josue-dubois/Human_Tracker/production/bom.csv

Designator | Footprint | Quantity | Value | LCSC Part #
C1 | C1712_C0805 | 1 | 10uF | C1712
C10, C4 | C1712_C0805 | 2 | 0.1u | C1712
C11 | C1712_C0805 | 1 | 1nF (102) ±5% 50V | C1712
C12, C13 | C1712_C0805 | 2 | 4.7uF | C1712
C14 | C1712_C0805 | 1 | 1uF | C1712
C15, C16, C18 | C1712_C0805 | 3 | 100n | C1712
C17 | C15850_C0805 | 1 | 10uF | C15850
C2, C9 | C1712_C0805 | 2 | 100nF | C1712
C3 | C1712_C0805 | 1 | 10nF | C1712
C5 | C1712_C0805 | 1 | 47pF | C1712
C6 | C1712_C0805 | 1 | 4.7nF | C1712
C7 | C1712_C0805 | 1 | GRM21BR61A476ME15L 47uF | C1712
C8 | C1712_C0805 | 1 | 22uF | C1712
D1 | C7519_SOT-23-6_L2_9-W1_6-P0_95-LS2_8-BL | 1 | USBLC6-2SC6 | C7519
H2, H3 | C725946_HDR-TH_14P-P2_54-V-M | 2 | X6511WV-14H-C30D60 | C725946
H4 | C725944_HDR-TH_12P-P2_54-V-M | 1 | X6511WV-12H-C30D60 | C725944
H5 | C706875_HDR-TH_3P-P2_54-V-M | 1 | X6511WV-03H-C30D60 | C706875
L1 | C168078_IND-SMD_L6_0-W6_0_FNR60XXS | 1 | FNR6045S150MT 15uH | C168078
LED1 | C74338_LED0402-R-RD | 1 | 0402 | C74338
R1 | C17414_R0805 | 1 | 150kΩ | C17414
R11 | C17414_R0805 | 1 | 10k | C17414
R12, R8 | C17414_R0805 | 2 | 100k | C17414
R13, R14 | C17414_R0805 | 2 | 4.7k | C17414
R15, R16 | C17414_R0805 | 2 | 1k | C17414
R2 | C17414_R0805 | 1 | 62kΩ | C17414
R3, R5 | C17414_R0805 | 2 | 5.1k | C17414
R4 | C17414_R0805 | 1 | FRC0805F2102TS 21k | C17414
R6 | C17414_R0805 | 1 | 10kΩ | C17414
R7 | C17414_R0805 | 1 | 2.8KΩ (2801) ±1% | C17414
SM1 | C19723500_SENSOR-TH_HLK-LD2410C-P | 1 | HLK-LD2410C-P | C19723500
TP1 | TestPoint_Pad_D2.0mm | 1 | Buck In
TP2 | TestPoint_Pad_D2.0mm | 1 | Buck Out
TP3 | TestPoint_Pad_D2.0mm | 1 | LDO
TP4 | TestPoint_Pad_D2.0mm | 1 | UWB_TX
TP5 | TestPoint_Pad_D2.0mm | 1 | UWB_RX
TP6 | TestPoint_Pad_D2.0mm | 1 | UWB_RXOK
TP7 | TestPoint_Pad_D2.0mm | 1 | UWB_CS
U1 | C2865142_SOIC-8_L4_9-W3_9-P1_27-LS6_0-BL | 1 | TPS54233QDRQ1 | C2865142
U2, U3 | C5656610_MIC-SMD_6P-L3_5-W2_7-P0_90-BL | 2 | ICS-43434_C5656610 | C5656610
U4 | C514342_DFN-8_L3_0-W3_0-P0_50-BL-EP | 1 | ADM7172ACPZ-3.3-R7 | C514342
U5 | Bosch_LGA-8_3x3mm_P0.8mm_ClockwisePinNumbering | 1 | BME680
U6 | C2913202_WIRELM-SMD_ESP32-S3-WROOM-1 | 1 | ESP32-S3-WROOM-1(N16R8) | C2913202
U7 | C488251_TO-39-4_MLX90640ESF-BAB-000-TU | 1 | MLX90640ESF-BAB-000-TU | C488251
U8 | C2930166_R0805 | 1 | FRC0805F1400TS 140 | C2930166
USB1 | C7095263_USC-C-SMD_USB4085-GF-A | 1 | USB4085-GF-A_C7095263 | C7095263
WIRELM1 | C3028890_WIRELM-SMD_DWM3000 | 1 | DWM3000 | C3028890
