josue-dubois/Human_Tracker/Human_Tracker.kicad_pcb

## KiCad design Human_Tracker.kicad_pcb (2026-10-14)

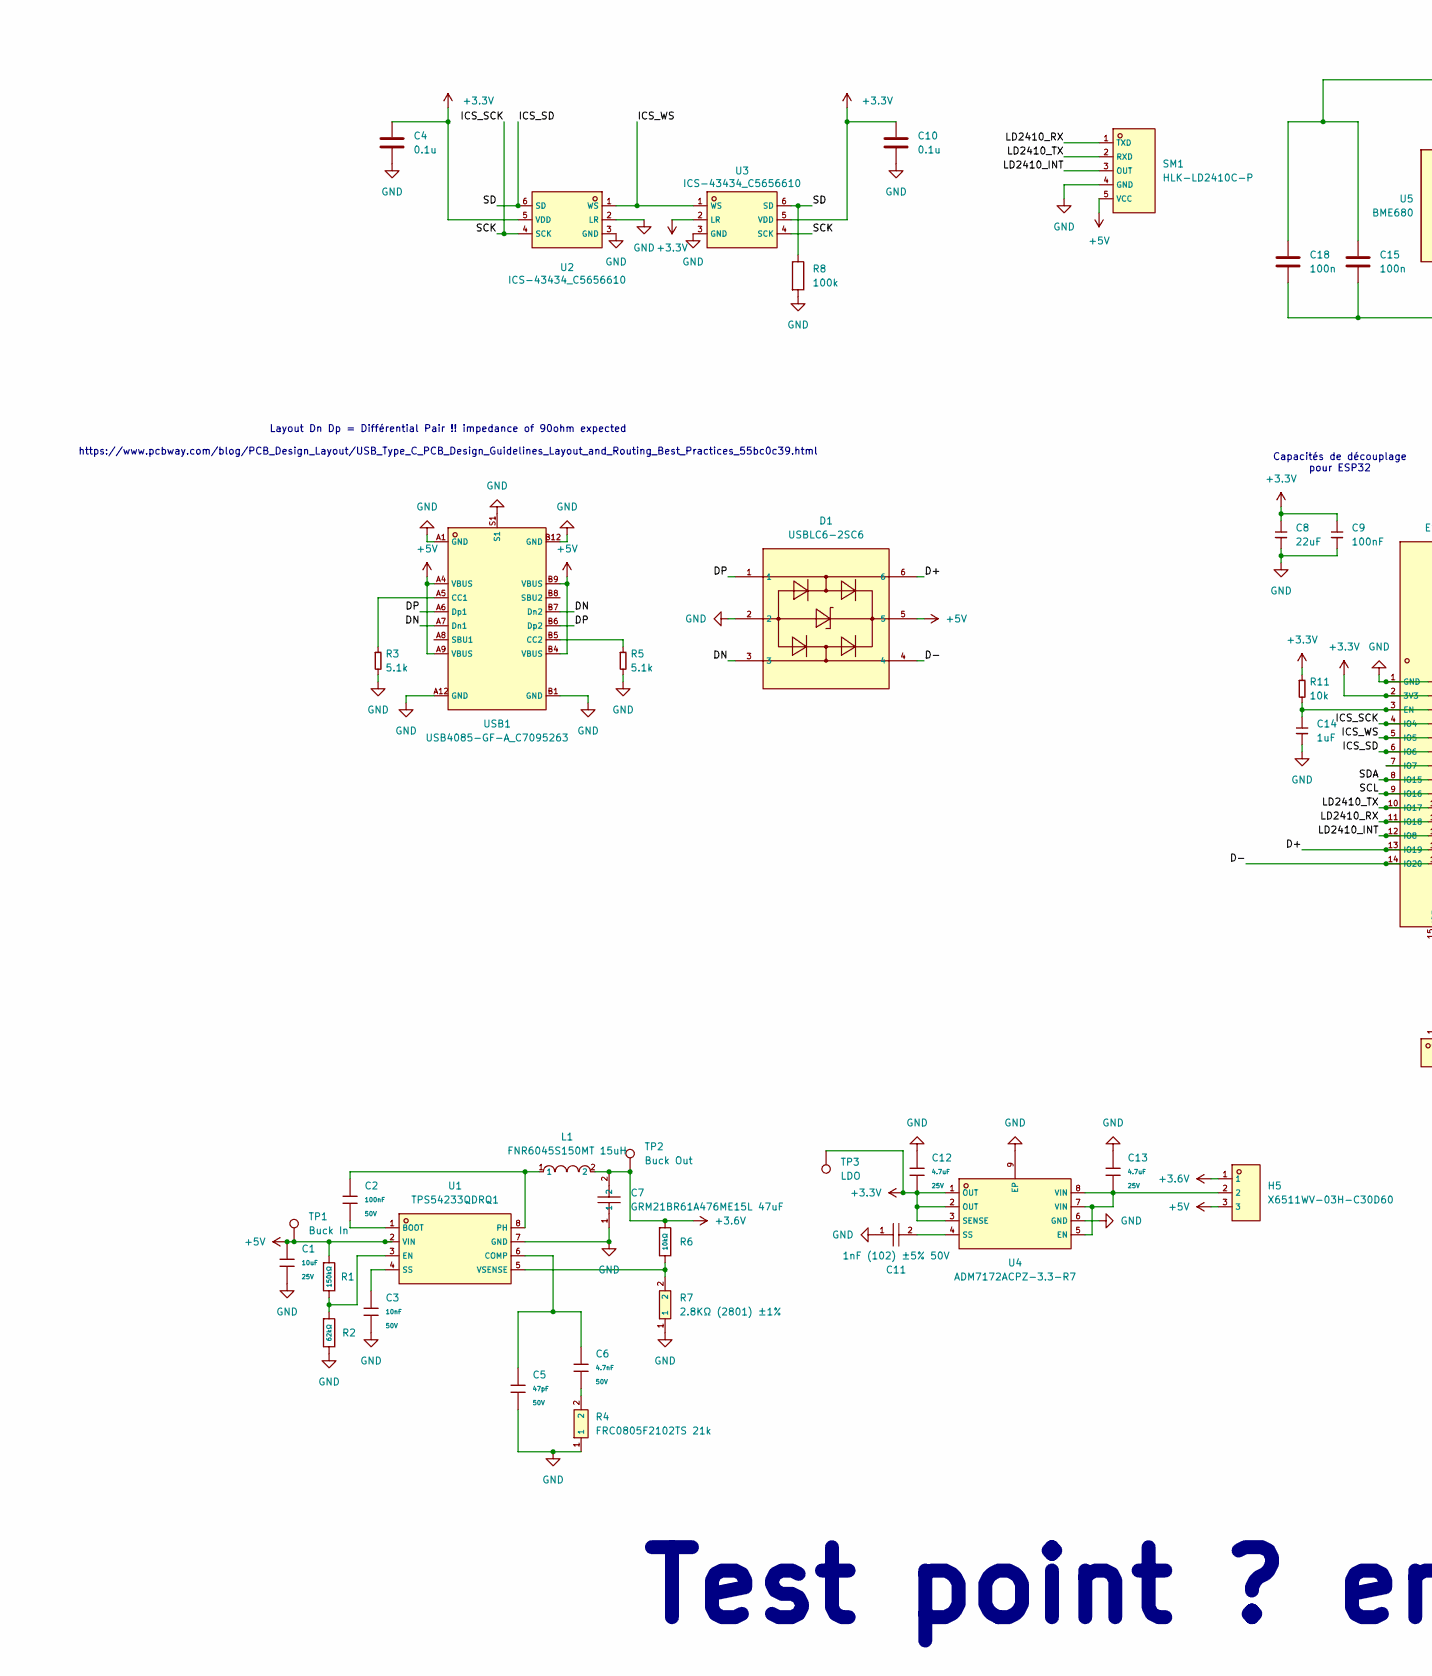
[picture p1: schematic Human_Tracker.kicad_sch, Human Tracker, part in row 1, column 1]

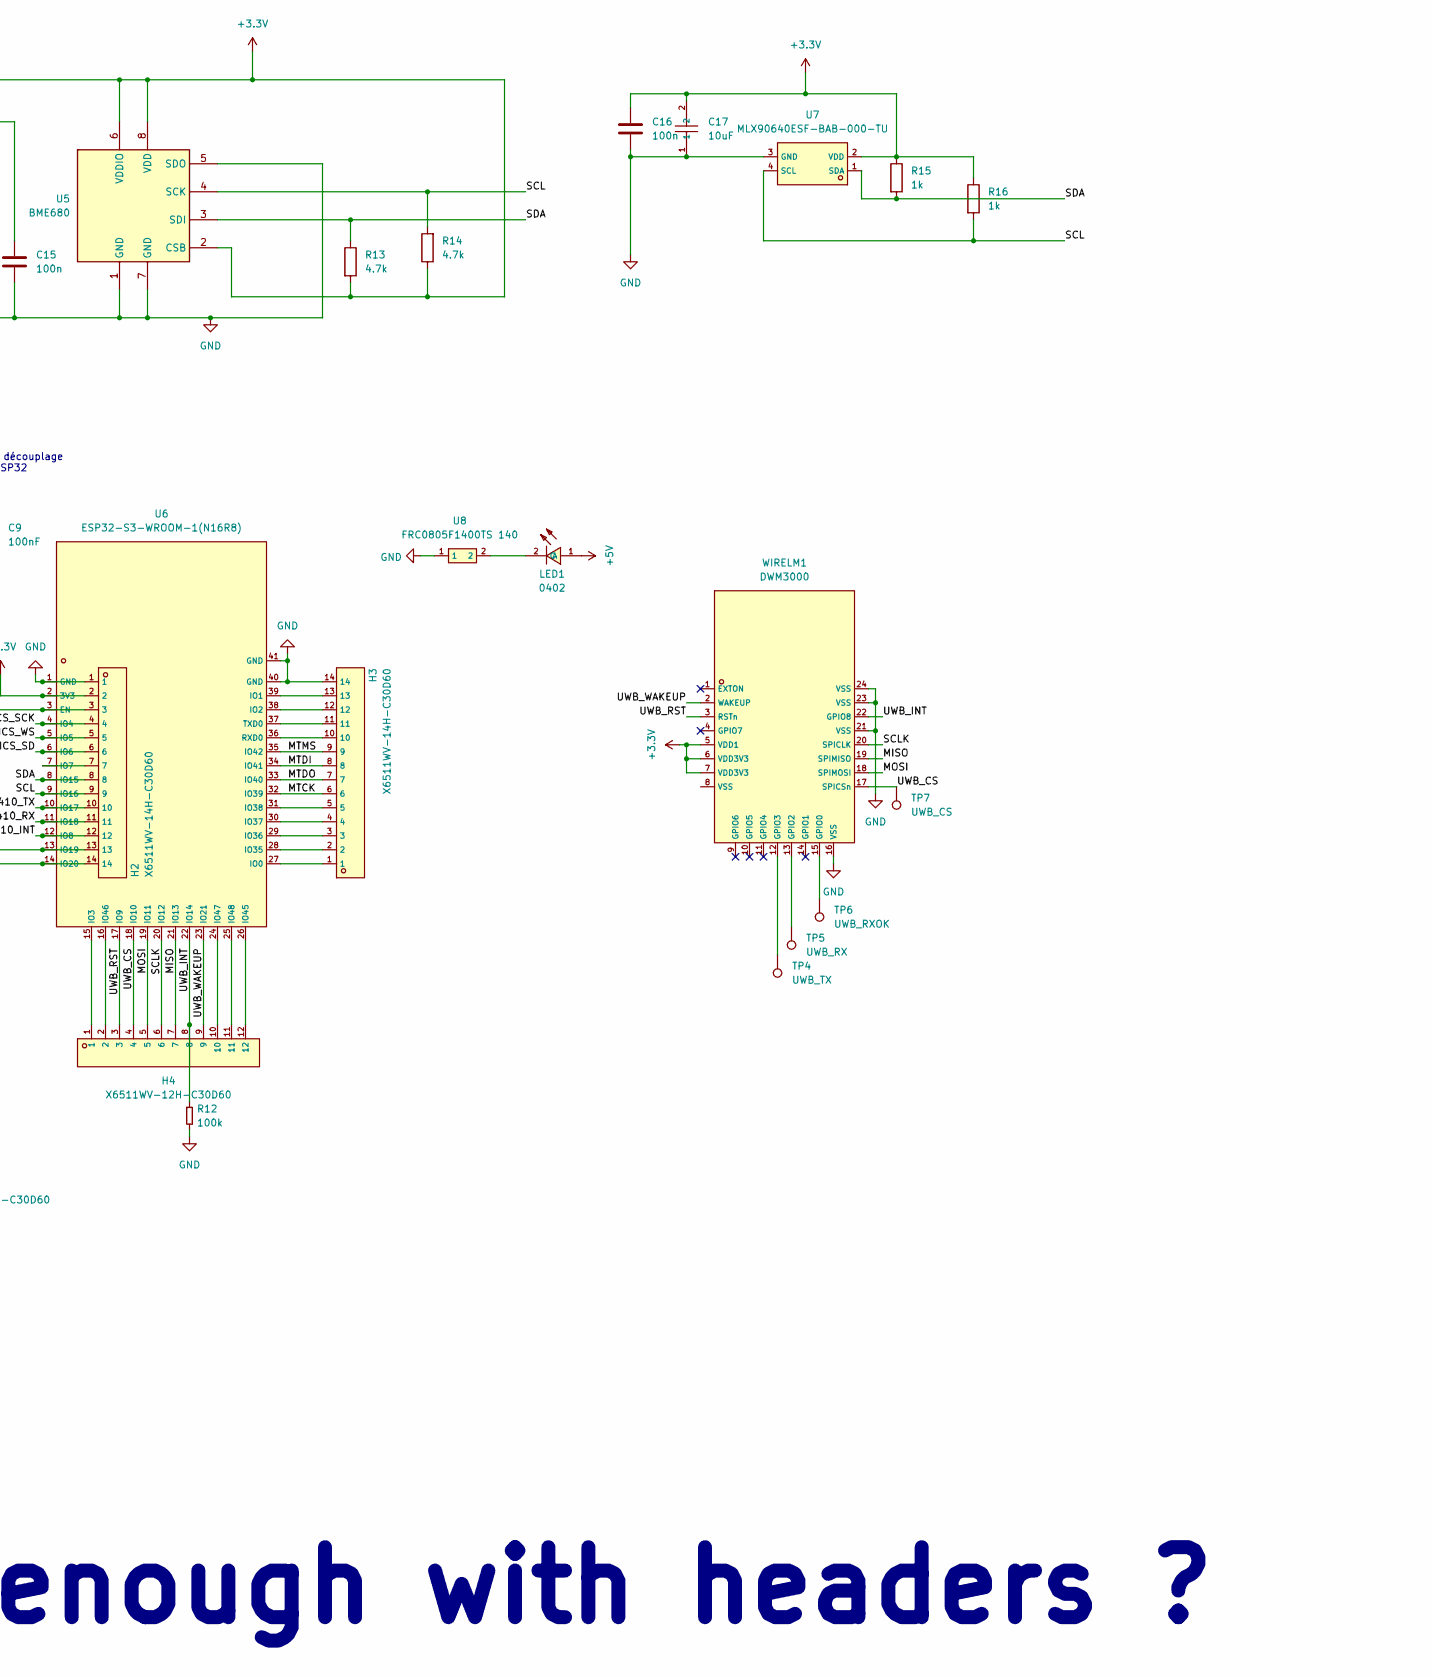
[picture p2: schematic Human_Tracker.kicad_sch, Human Tracker, part in row 1, column 2]

Parts:
C1: 10uF; C1712_C0805; Voltage Rated 25V; Tolerance ±10%; Part CL21A106KAYNNNE; LCSC C15850
C2: 100nF; C1712_C0805; Voltage Rated 50V; Tolerance ±10%; Part CC0805KRX7R9BB104; LCSC C49678
C3: 10nF; C1712_C0805; Voltage Rated 50V; Tolerance ±10%; Part CL21B103KBANNNC; LCSC C1710
C4, C10: 0.1u; C1712_C0805
C5: 47pF; C1712_C0805; Voltage Rated 50V; Tolerance ±5%; Part CL21C470JBANNNC; LCSC C14857
C6: 4.7nF; C1712_C0805; Voltage Rated 50V; Tolerance ±10%; Part 0805B472K500NT; LCSC C1744
C7: GRM21BR61A476ME15L 47uF; C1712_C0805; LCSC C124129
C8: 22uF; C1712_C0805; LCSC C29277
C9: 100nF; C1712_C0805; LCSC C49678
C11: 1nF (102) ±5% 50V; C1712_C0805; LCSC C1791
C12, C13: 4.7uF; C1712_C0805; Voltage Rated 25V; Tolerance ±10%; Part CL21A475KAQNNNE; LCSC C1779
C14: 1uF; C1712_C0805; LCSC C1712
C15, C16, C18: 100n; C1712_C0805
C17: 10uF; C15850_C0805; LCSC C15850
D1: USBLC6-2SC6; C7519_SOT-23-6_L2_9-W1_6-P0_95-LS2_8-BL; LCSC C7519
H2, H3: X6511WV-14H-C30D60; C725946_HDR-TH_14P-P2_54-V-M; LCSC C725946
H4: X6511WV-12H-C30D60; C725944_HDR-TH_12P-P2_54-V-M; LCSC C725944
H5: X6511WV-03H-C30D60; C706875_HDR-TH_3P-P2_54-V-M; LCSC C706875
L1: FNR6045S150MT 15uH; C168078_IND-SMD_L6_0-W6_0_FNR60XXS; LCSC C168078
LED1: 0402; C74338_LED0402-R-RD; LCSC C74338
R1: 150kΩ; C17414_R0805; Overload Voltage (Max) 150V; Tolerance ±1%; Part 0805W8F1503T5E; LCSC C17470
R2: 62kΩ; C17414_R0805; Overload Voltage (Max) 150V; Tolerance ±1%; Part 0805W8F6202T5E; LCSC C17783
R3, R5: 5.1k; C17414_R0805; LCSC C26023
R4: FRC0805F2102TS 21k; C17414_R0805; LCSC C2933366
R6: 10kΩ; C17414_R0805; Overload Voltage (Max) 150V; Tolerance ±1%; Part 0805W8F1002T5E; LCSC C17414
R7: 2.8KΩ (2801) ±1%; C17414_R0805; LCSC C17534
R8, R12: 100k; C17414_R0805; LCSC C25611
R11: 10k; C17414_R0805; LCSC C17414
R13, R14: 4.7k; C17414_R0805
R15, R16: 1k; C17414_R0805
SM1: HLK-LD2410C-P; C19723500_SENSOR-TH_HLK-LD2410C-P; LCSC C19723500
TP1: Buck In; TestPoint_Pad_D2.0mm
TP2: Buck Out; TestPoint_Pad_D2.0mm
TP3: LDO; TestPoint_Pad_D2.0mm
TP4: UWB_TX; TestPoint_Pad_D2.0mm
TP5: UWB_RX; TestPoint_Pad_D2.0mm
TP6: UWB_RXOK; TestPoint_Pad_D2.0mm
TP7: UWB_CS; TestPoint_Pad_D2.0mm
U1: TPS54233QDRQ1; C2865142_SOIC-8_L4_9-W3_9-P1_27-LS6_0-BL; LCSC C2865142
U2, U3: ICS-43434_C5656610; C5656610_MIC-SMD_6P-L3_5-W2_7-P0_90-BL; LCSC C5656610
U4: ADM7172ACPZ-3.3-R7; C514342_DFN-8_L3_0-W3_0-P0_50-BL-EP; LCSC C514342
U5: BME680; Bosch_LGA-8_3x3mm_P0.8mm_ClockwisePinNumbering
U6: ESP32-S3-WROOM-1(N16R8); C2913202_WIRELM-SMD_ESP32-S3-WROOM-1; LCSC C2913202
U7: MLX90640ESF-BAB-000-TU; C488251_TO-39-4_MLX90640ESF-BAB-000-TU; LCSC C488251
U8: FRC0805F1400TS 140; C2930166_R0805; LCSC C2930166
USB1: USB4085-GF-A_C7095263; C7095263_USC-C-SMD_USB4085-GF-A; LCSC C7095263
WIRELM1: DWM3000; C3028890_WIRELM-SMD_DWM3000; LCSC C3028890

Connections:
+3.3V: C4.1, C8.1, C9.1, C10.1, C12.2, C15.1, C16.1, C17.2, C18.1, H2.2, R11.1, R13.2, R14.1, R15.1, R16.1, TP3.1 (1_1), U2.5 (VDD), U3.2 (LR), U3.5 (VDD), U4.1 (OUT), U4.2 (OUT), U4.3 (SENSE), U5.2 (CSB), U5.6 (VDDIO), U5.8 (VDD), U6.2 (3V3), U7.2 (VDD), WIRELM1.5 (VDD1), WIRELM1.6 (VDD3V3), WIRELM1.7 (VDD3V3)
+3.6V: C7.2, H5.1, L1.2, R6.1, TP2.1 (1_1)
+5V: C1.1, D1.5, H5.3, LED1.1 (A), R1.1, SM1.5 (VCC), TP1.1 (1_1), U1.2 (VIN), USB1.A4 (VBUS), USB1.A9 (VBUS), USB1.B4 (VBUS), USB1.B9 (VBUS)
/D+: D1.6, H2.13, U6.13 (IO19)
/D-: D1.4, H2.14, U6.14 (IO20)
/DN: D1.3, USB1.A7 (Dn1), USB1.B7 (Dn2)
/DP: D1.1, USB1.A6 (Dp1), USB1.B6 (Dp2)
/ICS_SCK: H2.4, U2.4 (SCK), U3.4 (SCK), U6.4 (IO4)
/ICS_SD: H2.6, R8.1, U2.6 (SD), U3.6 (SD), U6.6 (IO6)
/ICS_WS: H2.5, U2.1 (WS), U3.1 (WS), U6.5 (IO5)
/LD2410_INT: H2.12, SM1.3 (OUT), U6.12 (IO8)
/LD2410_RX: H2.11, SM1.1 (TXD), U6.11 (IO18)
/LD2410_TX: H2.10, SM1.2 (RXD), U6.10 (IO17)
/MISO: H4.7, U6.21 (IO13), WIRELM1.19 (SPIMISO)
/MOSI: H4.5, U6.19 (IO11), WIRELM1.18 (SPIMOSI)
/MTCK: H3.6, U6.32 (IO39)
/MTDI: H3.8, U6.34 (IO41)
/MTDO: H3.7, U6.33 (IO40)
/MTMS: H3.9, U6.35 (IO42)
/SCL: H2.9, R14.2, R16.2, U5.4 (SCK), U6.9 (IO16), U7.4 (SCL)
/SCLK: H4.6, U6.20 (IO12), WIRELM1.20 (SPICLK)
/SDA: H2.8, R13.1, R15.2, U5.3 (SDI), U6.8 (IO15), U7.1 (SDA)
/UWB_CS: H4.4, TP7.1 (1_1), U6.18 (IO10), WIRELM1.17 (SPICSn)
/UWB_INT: H4.8, R12.1, U6.22 (IO14), WIRELM1.22 (GPIO8)
/UWB_RST: H4.3, U6.17 (IO9), WIRELM1.3 (RSTn)
/UWB_WAKEUP: H4.9, U6.23 (IO21), WIRELM1.2 (WAKEUP)
GND: C1.2, C3.2, C4.2, C5.2, C7.1, C8.2, C9.2, C10.2, C11.1, C12.1, C13.1, C14.2, C15.2, C16.2, C17.1, C18.2, D1.2, H2.1, H3.14, R2.2, R3.2, R4.1, R5.2, R7.1, R8.2, R12.2, SM1.4 (GND), U1.7 (GND), U2.2 (LR), U2.3 (GND), U3.3 (GND), U4.6 (GND), U4.9 (EP), U5.1 (GND), U5.5 (SDO), U5.7 (GND), U6.1 (GND), U6.40 (GND), U6.41 (GND), U7.3 (GND), U8.1, USB1.A1 (GND), USB1.A12 (GND), USB1.B1 (GND), USB1.B12 (GND), USB1.S1, WIRELM1.16 (VSS), WIRELM1.21 (VSS), WIRELM1.23 (VSS), WIRELM1.24 (VSS)
unnamed: C6.2, R4.2
unnamed: LED1.2 (C), U8.2
unnamed: C2.2, U1.1 (BOOT)
unnamed: C5.1, C6.1, U1.6 (COMP)
unnamed: R1.2, R2.1, U1.3 (EN)
unnamed: C2.1, L1.1, U1.8 (PH)
unnamed: C3.1, U1.4 (SS)
unnamed: R6.2, R7.2, U1.5 (VSENSE)
unnamed: C13.2, H5.2, U4.5 (EN), U4.7 (VIN), U4.8 (VIN)
unnamed: C11.2, U4.4 (SS)
unnamed: C14.1, H2.3, R11.2, U6.3 (EN)
unnamed: H3.1, U6.27 (IO0)
unnamed: H3.13, U6.39 (IO1)
unnamed: H3.12, U6.38 (IO2)
unnamed: H4.1, U6.15 (IO3)
unnamed: H2.7, U6.7 (IO7)
unnamed: H3.2, U6.28 (IO35)
unnamed: H3.3, U6.29 (IO36)
unnamed: H3.4, U6.30 (IO37)
unnamed: H3.5, U6.31 (IO38)
unnamed: H4.12, U6.26 (IO45)
unnamed: H4.2, U6.16 (IO46)
unnamed: H4.10, U6.24 (IO47)
unnamed: H4.11, U6.25 (IO48)
unnamed: H3.10, U6.36 (RXD0)
unnamed: H3.11, U6.37 (TXD0)
unnamed: R3.1, USB1.A5 (CC1)
unnamed: R5.1, USB1.B5 (CC2)
unnamed: TP6.1 (1_1), WIRELM1.15 (GPIO0)
unnamed: TP5.1 (1_1), WIRELM1.13 (GPIO2)
unnamed: TP4.1 (1_1), WIRELM1.12 (GPIO3)

Notes on the sheet:
Test point ? enough with headers ?
Capacités de découplage pour ESP32
Layout Dn Dp = Différential Pair !! impedance of 90ohm expected https://www.pcbway.com/blog/PCB_Design_Layout/USB_Type_C_PCB_Design_Guidelines_Layout_and_Routing_Best_Practices_55bc0c39.html

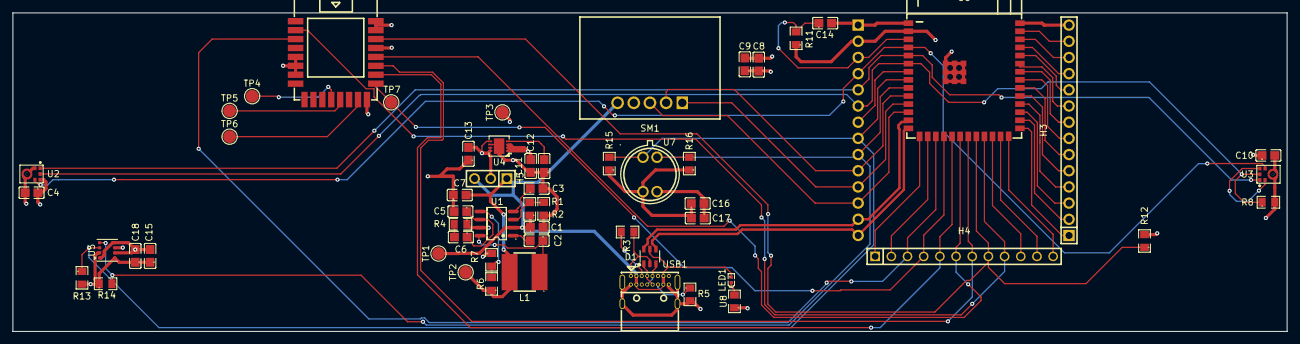
[picture p3: board Human_Tracker.kicad_pcb from above]

Board: 4 copper layers, 200.0 x 50.0 mm, 57 parts (1 on the bottom side), 58 nets.
